houhouoch/UDP3900/Readme.md

屏幕暂定为3.71寸
使用的是SPI+RGB  +带触摸的IIC
屏幕驱动为ST7701S   触摸IC为CST3240
其中  屏幕驱动：使用的是三线SPI  9位bit  
此屏幕没有DC引脚，也就是没有专门的控制位来告诉MCU 这个数据是 命令还是数据
这里使用模拟SPI 的方式去初始化 因为是9位，如果使用spi外设来写 会很麻烦

第一步 初始spi 的gpio口
