houhouoch/UDP3900/APP/UDP3900_3.27_Btn/Readme.md

按键布局大致做了以下修改

后续的按键

后续定好的按键
8885ff6d24081e829a78c13145390b2e
