houhouoch/UDP3900/APP/Readme.md

## 📂 工程演进明细表 (Project Roadmap)

| 工程文件夹名称 | 开发日期 | 项目功能说明 |
| :--- | :---: | :--- |
| **UDP3900_3.25** |3.25 |SDRAM 读写测试 |
| **UDP3900_3.25_LTDC** | 3.25 | 显示屏移植与显示 |
| **UDP3900_3.25_DMA2D** | 3.25 |DMA2D使用。 |
| **UDP3900_3.26_FreeRTOS** | 3.26 |移植RTOS。 |
| **UDP3900_3.26_FreeRTOS_LVGLS** | 3.26 |移植LVGL。 |
| **UDP3900_3.27_FreeRTOS_LVGL_MUTEX_TEST** | 3.27 |修改了DMA2D,增加了互斥锁。 |
| **UDP3900_3.27_Btn** | 3.27 |把对应按键进行增加。 |
---
