houhouoch/UDP3900/其他/HD371001C40带触摸/56ff643bea4310fa22435de5ab40d1ec.jpg

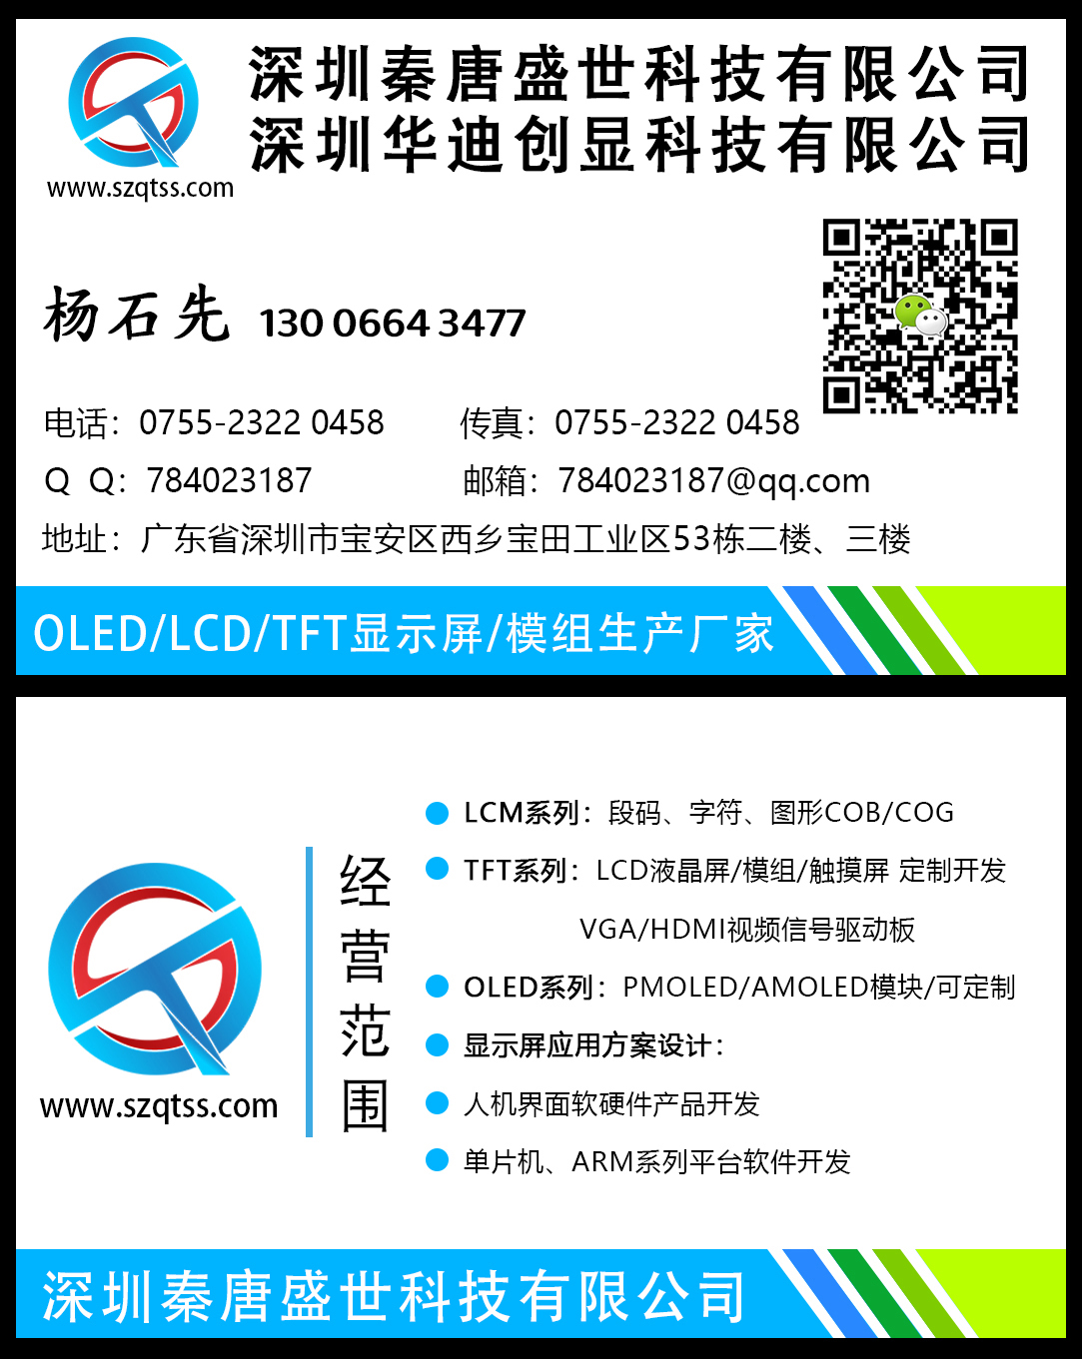
其他/HD371001C40带触摸/56ff643bea4310fa22435de5ab40d1ec.jpg
