houhouoch/UDP3900/其他/HD371001C40带触摸/屏参数.png

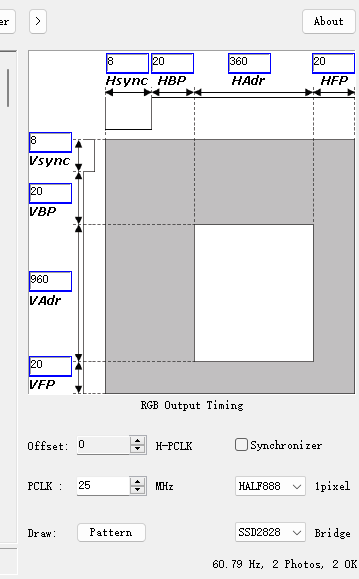
其他/HD371001C40带触摸/屏参数.png
