houhouoch/UDP3900/其他/1U 按键、显示、核心板/1U 按键.pdf

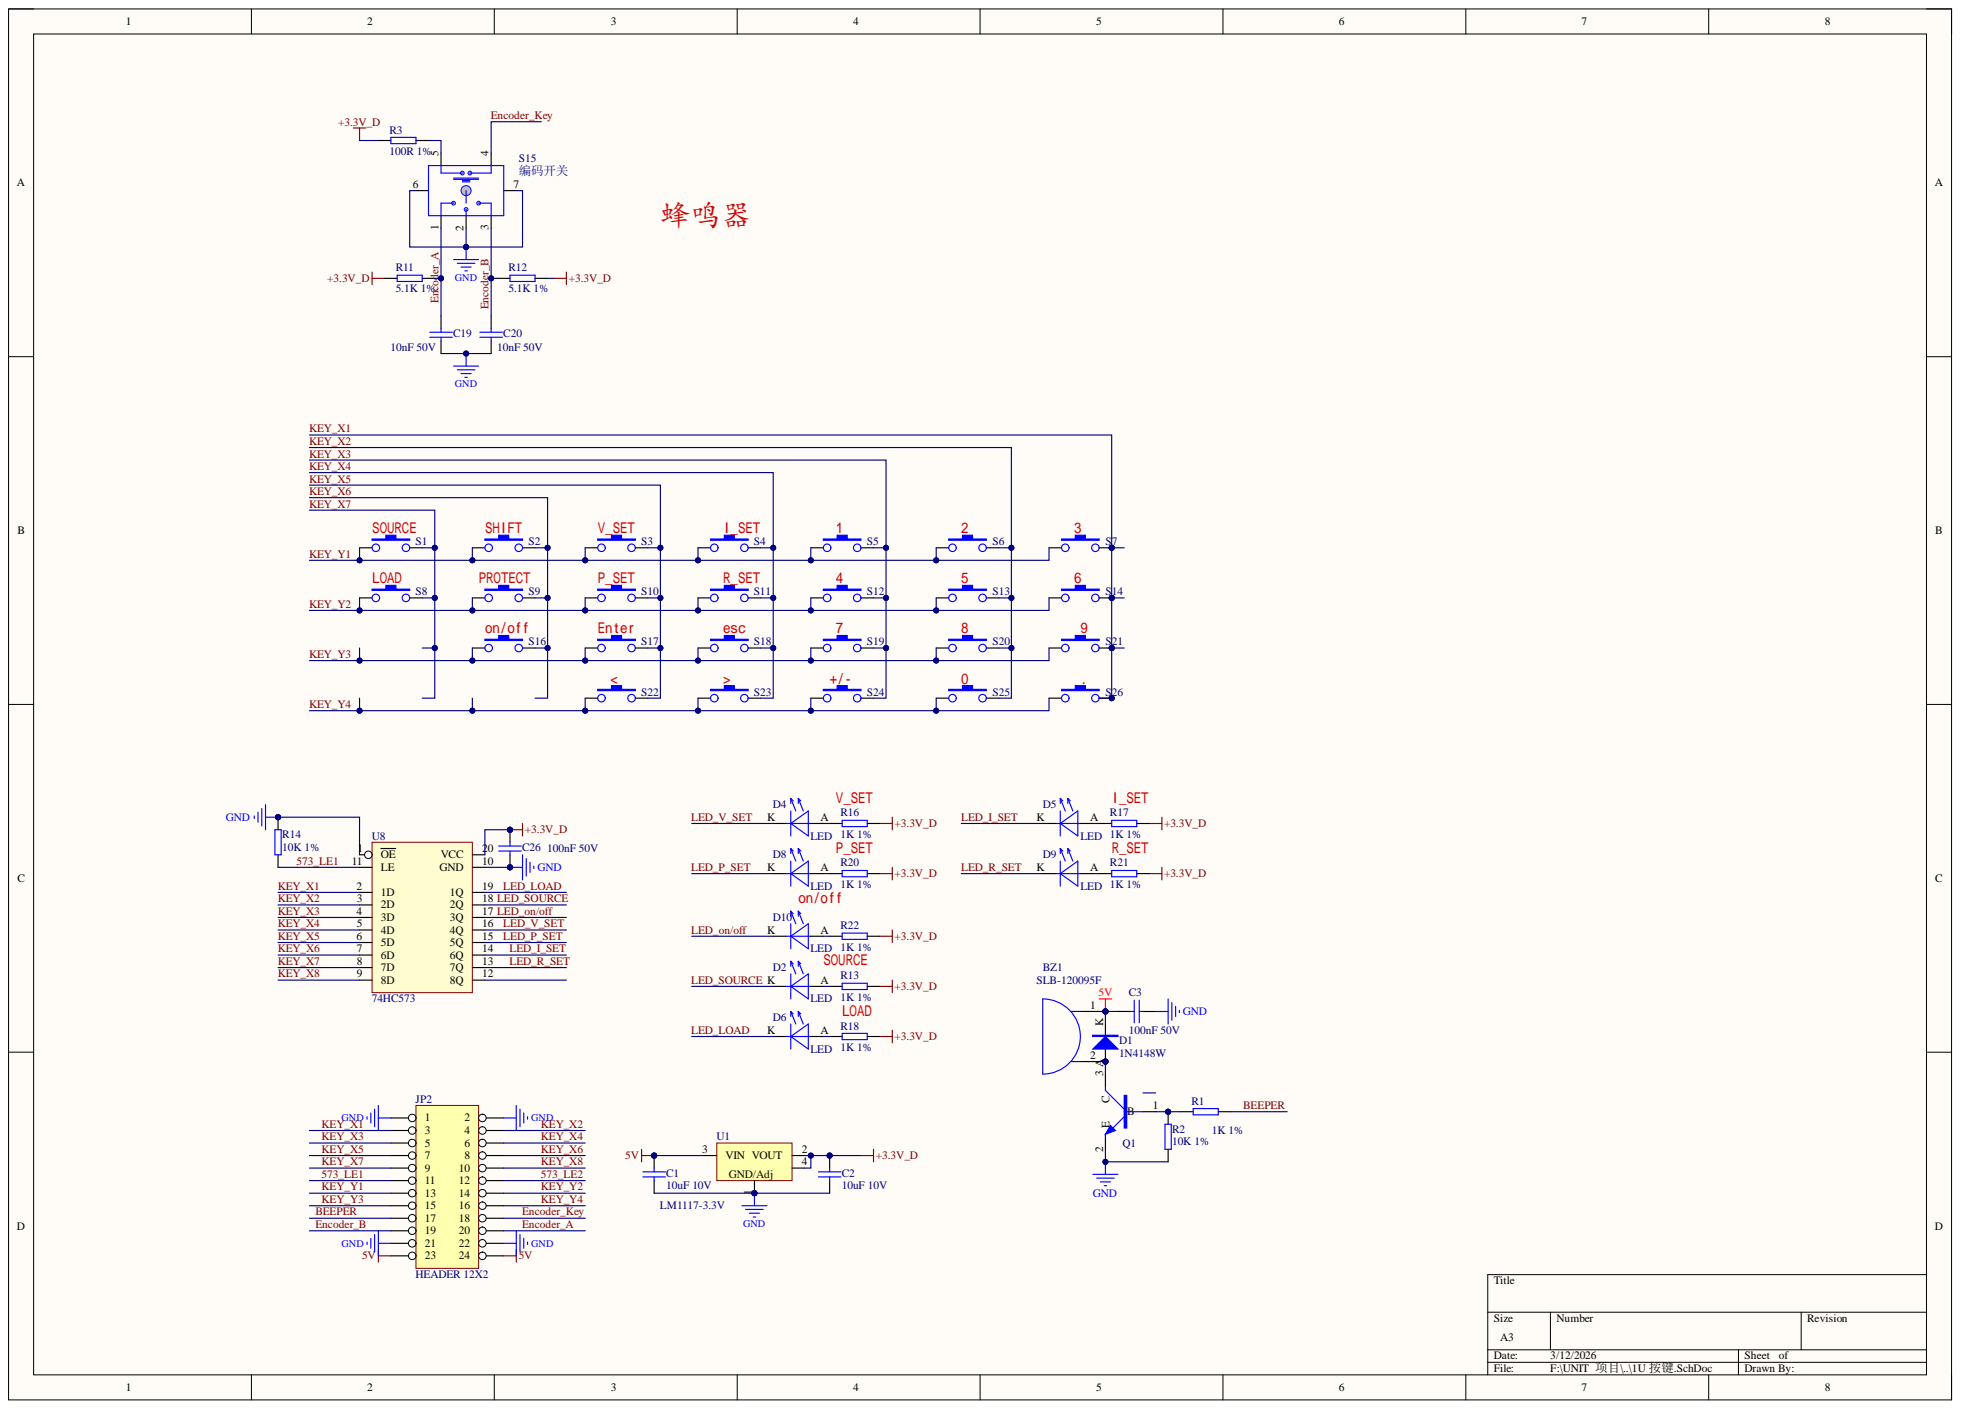
[picture p3: page 1]
