houhouoch/UDP3900/其他/1U 按键、显示、核心板/1U 显示.pdf

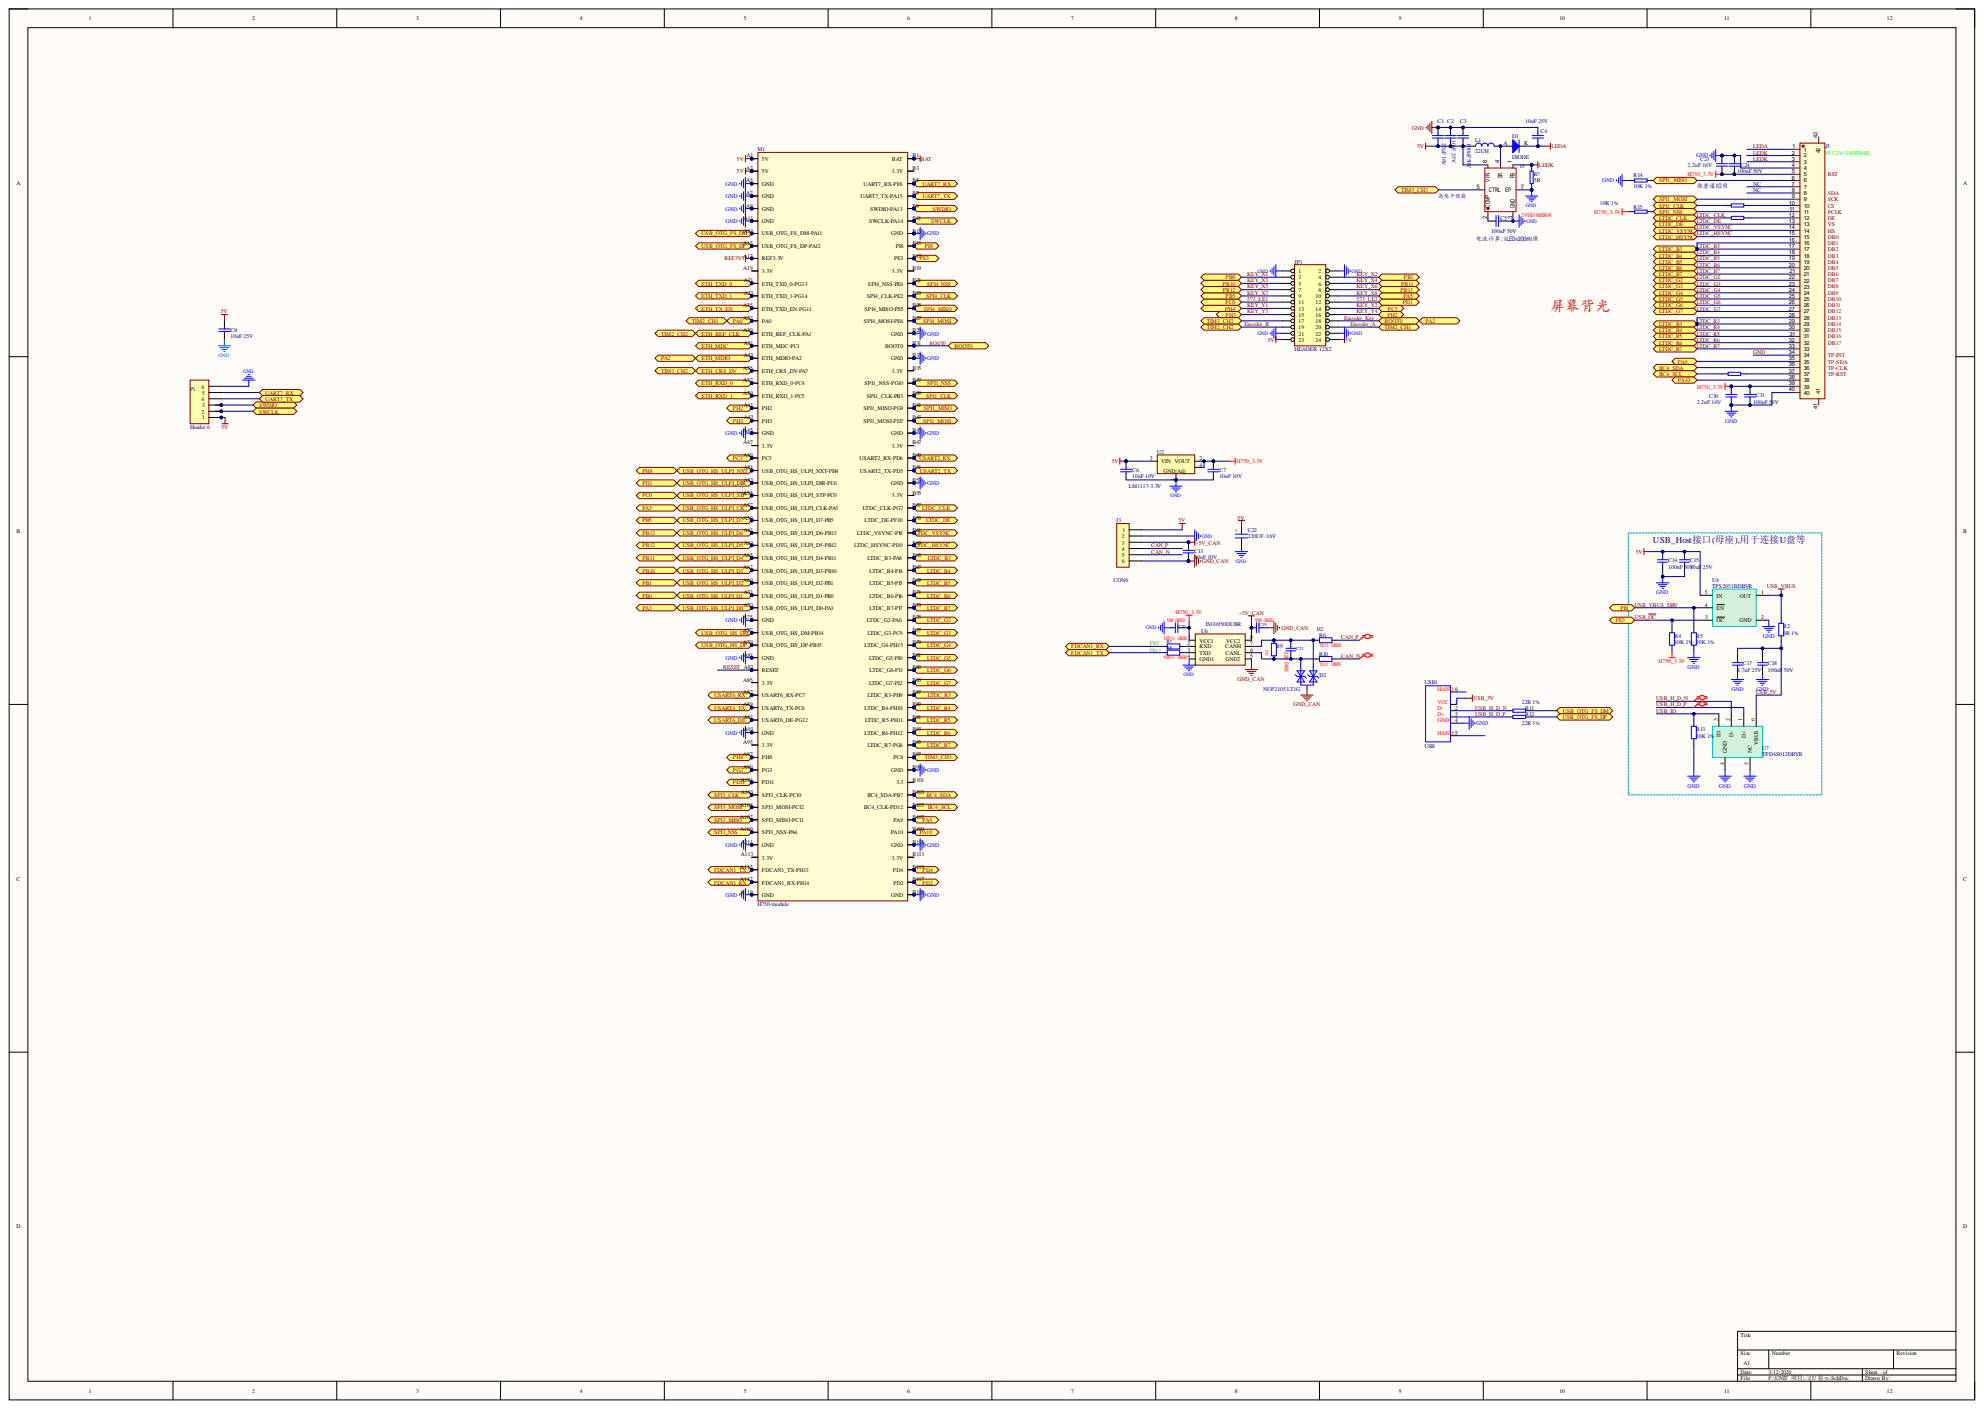
[picture p4: page 1]
