houhouoch/UDP3900/其他/1U 按键、显示、核心板/通用核心板.pdf

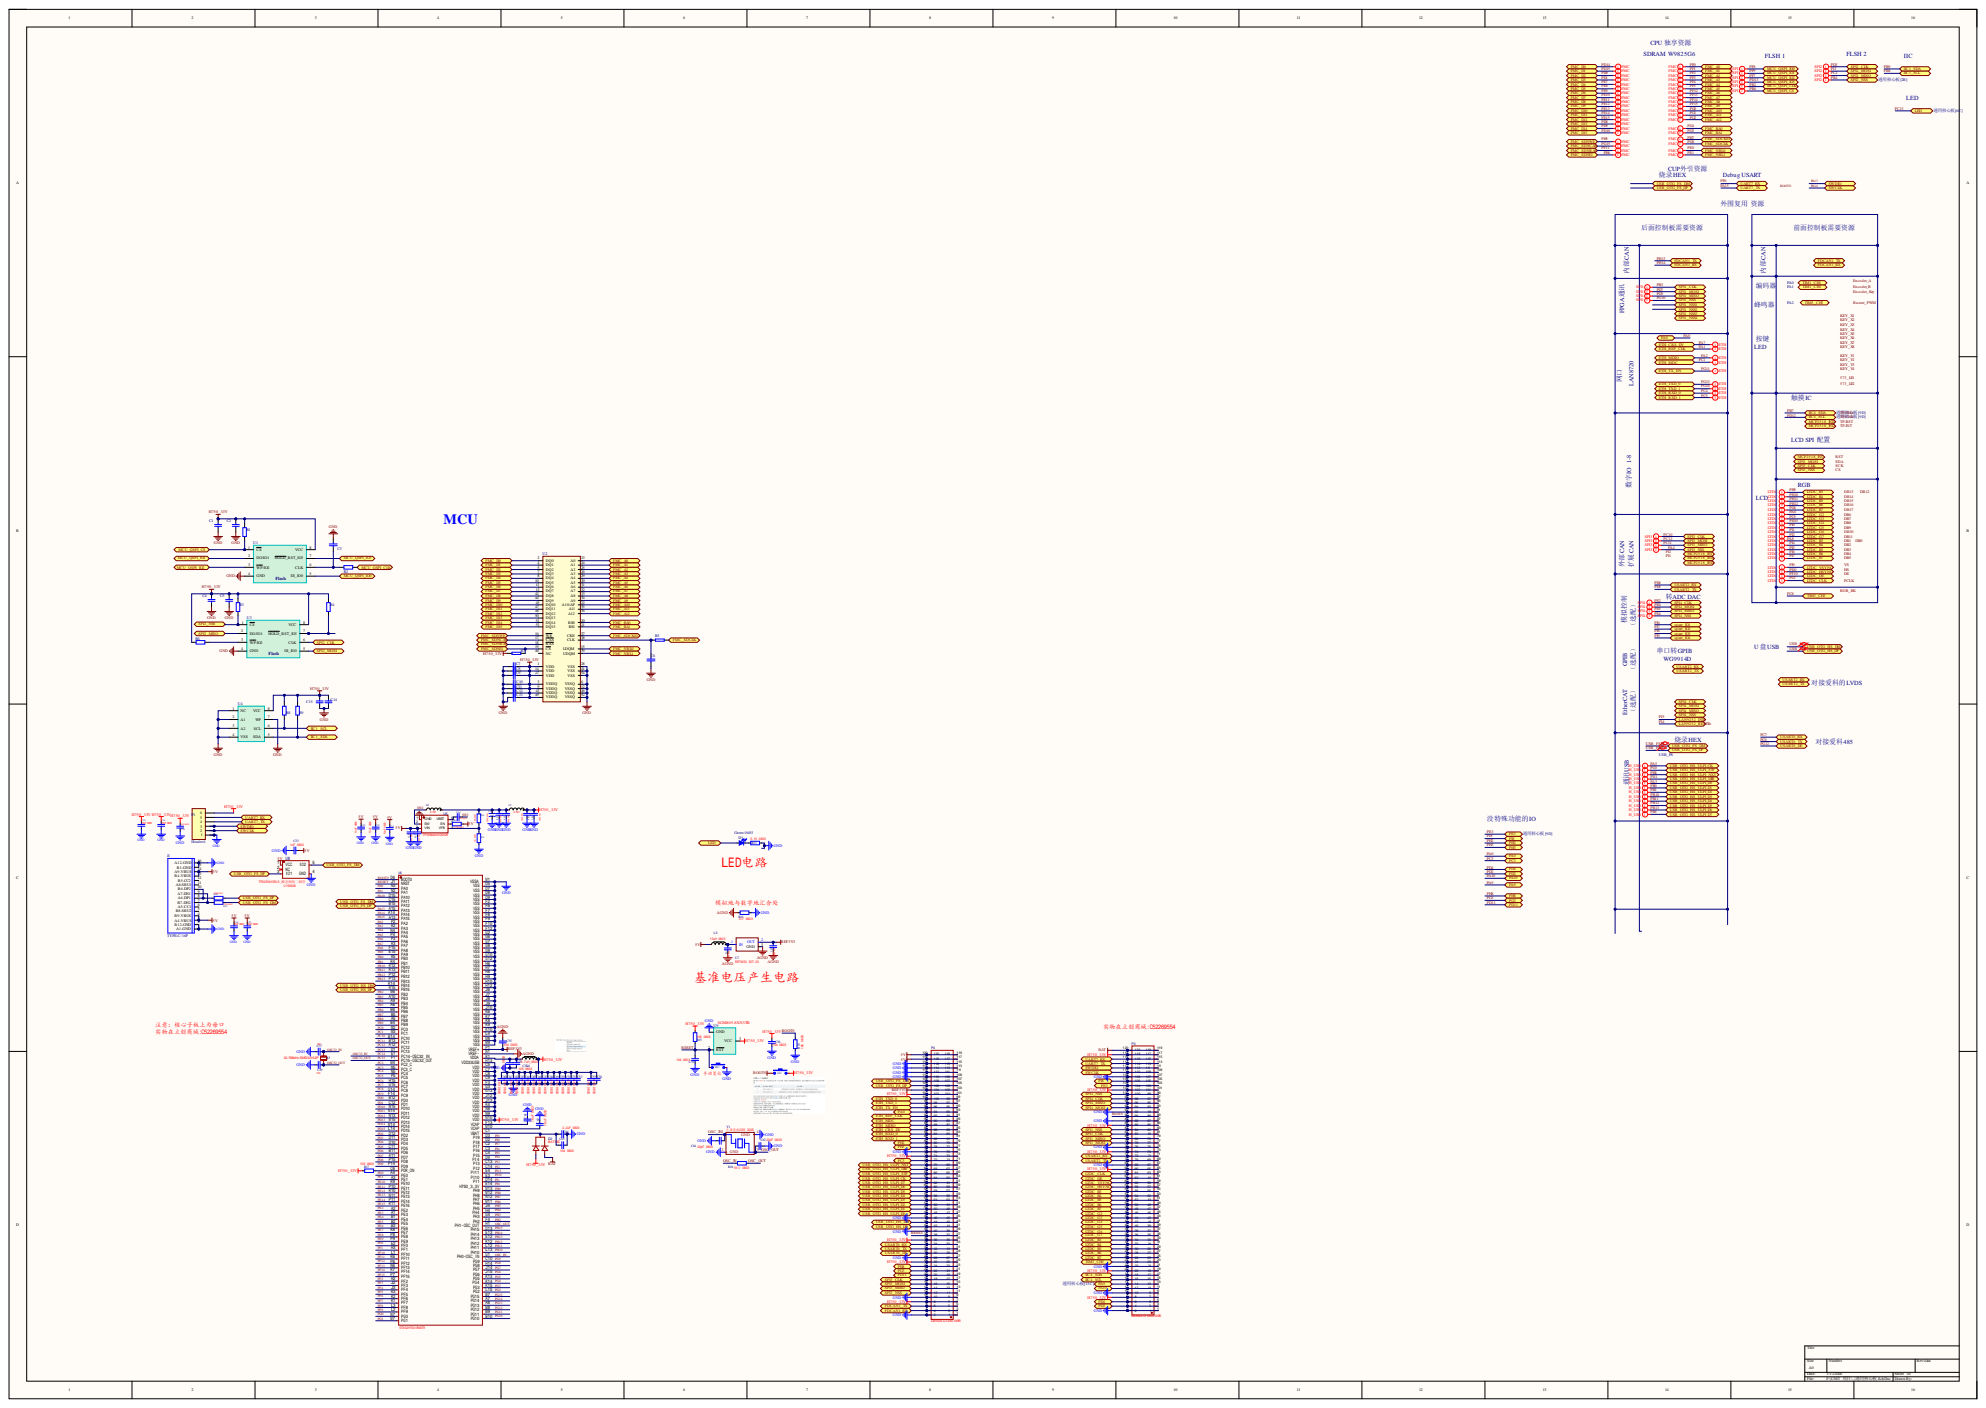
[picture p5: page 1]

数字IO 1-8 （选配） GPIB （选配） EtherCAT （选配）

C4 GND S P I 2 _NS S P I 2 _ R6 | C5 S M I S

P P D5 D6 USAR T 2 _RX 转ADC DAC USAR T 2 _ TX P E 2 S S P P I4 I4 i i P P E E 5 6 S S P P I4 I4 _ _ C MOS LK I S S P P I4 I4 i i P E4 S S P P I4 I4 _ _NS M I S S O P I 6P P I7 s s p p are are _ _ I I O1 O2 P P I I 8 9 s p are _ I O3 s p are _ I O4 串口转GP I B WG9 9 1 4D USAR USAR T T 2 2 _RX _ TX S P I4 _ C LK S P I4 _ MOS I S S P P I4 I4 _ _NS M I S S O P I4 I 5 LAN9 2 5 2 _ INTn LAN9 2 5 2 _ R E S ETn

H_US H_US H_US H_US H_US H_US H_US H_US H_US H_US H_US | 烧录HE US B _ F S_N USB_FS_P X US US B B _OTG_ _OTG_ F F S S _ _DP DM US B _ FS B i PA3 PA5 PB0 PB1 PB5 PB1 US B _OTG_HS _UL P I_CK B i P P C0 H4 US B _OTG_HS _UL P I_ S TP B B i i P I 1 1 US US B B _OTG_HS _OTG_HS _UL _UL P P I_NXT I_DIR USB_OTG_HS_ULPI_D0 B i B B i i US US B B _OTG_HS _OTG_HS _UL _UL P P I_D1 I_D2 B i H_USB i P B 1 1 0 US B _OTG_HS _UL P I_D3 USB_OTG_HS_ULPI_D4 B i P P B B 1 1 2 3 US B _OTG_HS _UL P I_D5 B B i i US US B B _OTG_HS _OTG_HS _UL _UL P P I_D6 I_D7
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
