houhouoch/UDP3900/(list of files, drawings)

Other design files:
其他/1U 按键/1U 按键.PrjPcb
其他/1U 按键/1U 按键.SchDoc
其他/1U 按键、显示、核心板/核心板/通用核心板.PrjPcb
其他/1U 按键、显示、核心板/核心板/通用核心板.SchDoc
其他/1U 显示/1U 显示.PcbDoc
其他/1U 显示/1U 显示.PrjPcb
其他/1U 显示/1U 显示.SchDoc
