houhouoch/UDP3900/QSPI_W25Q64_Flash的MDK下载算法制作/User/bsp/src/bsp_qspi_w25q256.c

/*
*********************************************************************************************************
*
*    模块名称 : W25Q256 QSPI驱动模块
*    文件名称 : bsp_qspi_w25q256.c
*    版    本 : V1.0
*    说    明 : 使用CPU的QSPI总线驱动串行FLASH，提供基本的读写函数，采用4线方式
*
*    修改记录 :
*        版本号  日期        作者     说明
*        V1.0    2019-02-12  armfly  正式发布
*        V1.1    2019-07-07  armfly  增加H7-TOOL引脚定义。
*
*    Copyright (C), 2019-2030, 安富莱电子 www.armfly.com
*
*********************************************************************************************************
*/
#include "stm32h7xx_hal.h"
#include "stm32h7xx_hal_pwr.h"
#include "stm32h7xx_hal_qspi.h"
#include "bsp_qspi_w25q256.h"

/**
 * @brief  3900项目 - QSPI Flash 接口引脚定义 (Bank 1)
 * @note   外设实例: QUADSPI
 * * | QSPI 信号 | 物理引脚 | 复用功能 (AF) | 核心板功能说明        |
 * |-----------|----------|---------------|-----------------------|
 * | CS        | PB6      | AF10          | QUADSPI_BK1_NCS       |
 * | CLK       | PB2      | AF9           | QUADSPI_CLK           |
 * | IO0       | PF8      | AF10          | QUADSPI_BK1_IO0       |
 * | IO1       | PF9      | AF10          | QUADSPI_BK1_IO1       |
 * | IO2       | PF7      | AF9           | QUADSPI_BK1_IO2       |
 * | IO3       | PD13     | AF9           | QUADSPI_BK1_IO3       |
 * 
 */


/* QSPI引脚和时钟相关配置宏定义 */
#if 1
#define QSPI_CLK_ENABLE()               __HAL_RCC_QSPI_CLK_ENABLE()
#define QSPI_CLK_DISABLE()              __HAL_RCC_QSPI_CLK_DISABLE()
#define QSPI_CS_GPIO_CLK_ENABLE()       __HAL_RCC_GPIOB_CLK_ENABLE()
#define QSPI_CLK_GPIO_CLK_ENABLE()      __HAL_RCC_GPIOB_CLK_ENABLE()
#define QSPI_BK1_D0_GPIO_CLK_ENABLE()   __HAL_RCC_GPIOF_CLK_ENABLE()
#define QSPI_BK1_D1_GPIO_CLK_ENABLE()   __HAL_RCC_GPIOF_CLK_ENABLE()
#define QSPI_BK1_D2_GPIO_CLK_ENABLE()   __HAL_RCC_GPIOF_CLK_ENABLE()
#define QSPI_BK1_D3_GPIO_CLK_ENABLE()   __HAL_RCC_GPIOD_CLK_ENABLE()

#define QSPI_MDMA_CLK_ENABLE()          __HAL_RCC_MDMA_CLK_ENABLE()
#define QSPI_FORCE_RESET()              __HAL_RCC_QSPI_FORCE_RESET()
#define QSPI_RELEASE_RESET()            __HAL_RCC_QSPI_RELEASE_RESET()

#define QSPI_CS_PIN                     GPIO_PIN_6
#define QSPI_CS_GPIO_PORT               GPIOB
#define QSPI_CS_GPIO_AF                 GPIO_AF10_QUADSPI

#define QSPI_CLK_PIN                    GPIO_PIN_2
#define QSPI_CLK_GPIO_PORT              GPIOB
#define QSPI_CLK_GPIO_AF                GPIO_AF9_QUADSPI

#define QSPI_BK1_D0_PIN                 GPIO_PIN_8
#define QSPI_BK1_D0_GPIO_PORT           GPIOF
#define QSPI_BK1_D0_GPIO_AF             GPIO_AF10_QUADSPI

#define QSPI_BK1_D1_PIN                 GPIO_PIN_9
#define QSPI_BK1_D1_GPIO_PORT           GPIOF
#define QSPI_BK1_D1_GPIO_AF             GPIO_AF10_QUADSPI

#define QSPI_BK1_D2_PIN                 GPIO_PIN_7
#define QSPI_BK1_D2_GPIO_PORT           GPIOF
#define QSPI_BK1_D2_GPIO_AF             GPIO_AF9_QUADSPI

#define QSPI_BK1_D3_PIN                 GPIO_PIN_13
#define QSPI_BK1_D3_GPIO_PORT           GPIOD
#define QSPI_BK1_D3_GPIO_AF             GPIO_AF9_QUADSPI
#endif


/* 供本文件调用的全局变量 */
static QSPI_HandleTypeDef QSPIHandle;

/* 供本文件调用的函数 */
static int QSPI_WriteEnable(QSPI_HandleTypeDef *hqspi);
static int QSPI_AutoPollingMemReady(QSPI_HandleTypeDef *hqspi);


/*
*********************************************************************************************************
*    函 数 名: bsp_InitQSPI_W25Q256
*    功能说明: QSPI Flash硬件初始化，配置基本参数
*    形    参: 无
*    返 回 值: 0 表示成功， 1 表示失败
*********************************************************************************************************
*/
int bsp_InitQSPI_W25Q256(void)
{
    uint32_t i;
    char *p;
    
    /* 将句柄手动清零，防止作为全局变量的时候没有清零 */
    p = (char *)&QSPIHandle;
    for (i = 0; i < sizeof(QSPI_HandleTypeDef); i++)
    {
        *p++ = 0;
    }
  
    /* 复位QSPI */
    QSPIHandle.Instance = QUADSPI;   
    
    if (HAL_QSPI_DeInit(&QSPIHandle) != HAL_OK)
    {
        return 1;
    }

    /* 设置时钟速度，QSPI clock = 200MHz / (ClockPrescaler+1) = 100MHz */
    QSPIHandle.Init.ClockPrescaler = 1;

    /* 设置FIFO阀值，范围1 - 32 */
    QSPIHandle.Init.FifoThreshold = 1;

    /* 
        QUADSPI在FLASH驱动信号后过半个CLK周期才对FLASH驱动的数据采样。
        在外部信号延迟时，这有利于推迟数据采样。
    */
    QSPIHandle.Init.SampleShifting = QSPI_SAMPLE_SHIFTING_HALFCYCLE;

    /* Flash大小是2^(FlashSize + 1) = 2^25 = 32MB */
    QSPIHandle.Init.FlashSize = QSPI_FLASH_SIZE; //QSPI_FLASH_SIZE - 1; 2020-03-04, 需要扩大一倍，否则内存映射方位最后1个地址时，会异常

    /* 命令之间的CS片选至少保持1个时钟周期的高电平 */
    QSPIHandle.Init.ChipSelectHighTime = QSPI_CS_HIGH_TIME_5_CYCLE;

    /*
       MODE0: 表示片选信号空闲期间，CLK时钟信号是低电平
       MODE3: 表示片选信号空闲期间，CLK时钟信号是高电平
    */
    QSPIHandle.Init.ClockMode = QSPI_CLOCK_MODE_0;

    /* QSPI有两个BANK，这里使用的BANK1 */
    QSPIHandle.Init.FlashID = QSPI_FLASH_ID_1;

    /* V7开发板仅使用了BANK1，这里是禁止双BANK */
    QSPIHandle.Init.DualFlash = QSPI_DUALFLASH_DISABLE;

    /* 初始化配置QSPI */
    if (HAL_QSPI_Init(&QSPIHandle) != HAL_OK)
    {
        return 1;
    }
    
    return 0;
}

/*
*********************************************************************************************************
*    函 数 名: HAL_QSPI_MspInit
*    功能说明: QSPI底层初始化，被HAL_QSPI_Init调用的底层函数
*    形    参: 无
*    返 回 值: 无
*********************************************************************************************************
*/
void HAL_QSPI_MspInit(QSPI_HandleTypeDef *hqspi)
{
    GPIO_InitTypeDef GPIO_InitStruct;

    /* 使能QPSI时钟  */
    QSPI_CLK_ENABLE();

    /* 复位时钟接口 */
    QSPI_FORCE_RESET();
    QSPI_RELEASE_RESET();    
    
    /* 使能GPIO时钟 */
    QSPI_CS_GPIO_CLK_ENABLE();
    QSPI_CLK_GPIO_CLK_ENABLE();
    QSPI_BK1_D0_GPIO_CLK_ENABLE();
    QSPI_BK1_D1_GPIO_CLK_ENABLE();
    QSPI_BK1_D2_GPIO_CLK_ENABLE();
    QSPI_BK1_D3_GPIO_CLK_ENABLE();

    /* QSPI CS GPIO 引脚配置 */
    GPIO_InitStruct.Pin = QSPI_CS_PIN;
    GPIO_InitStruct.Mode = GPIO_MODE_AF_PP;
    GPIO_InitStruct.Pull = GPIO_PULLUP;
    GPIO_InitStruct.Speed = GPIO_SPEED_FREQ_VERY_HIGH;
    GPIO_InitStruct.Alternate = QSPI_CS_GPIO_AF;
    HAL_GPIO_Init(QSPI_CS_GPIO_PORT, &GPIO_InitStruct);

    /* QSPI CLK GPIO 引脚配置 */
    GPIO_InitStruct.Pin = QSPI_CLK_PIN;
    GPIO_InitStruct.Pull = GPIO_NOPULL;
    GPIO_InitStruct.Alternate = QSPI_CLK_GPIO_AF;
    HAL_GPIO_Init(QSPI_CLK_GPIO_PORT, &GPIO_InitStruct);

    /* QSPI D0 GPIO pin 引脚配置 */
    GPIO_InitStruct.Pin = QSPI_BK1_D0_PIN;
    GPIO_InitStruct.Alternate = QSPI_BK1_D0_GPIO_AF;
    HAL_GPIO_Init(QSPI_BK1_D0_GPIO_PORT, &GPIO_InitStruct);

    /* QSPI D1 GPIO 引脚配置 */
    GPIO_InitStruct.Pin = QSPI_BK1_D1_PIN;
    GPIO_InitStruct.Alternate = QSPI_BK1_D1_GPIO_AF;
    HAL_GPIO_Init(QSPI_BK1_D1_GPIO_PORT, &GPIO_InitStruct);

    /* QSPI D2 GPIO 引脚配置 */
    GPIO_InitStruct.Pin = QSPI_BK1_D2_PIN;
    GPIO_InitStruct.Alternate = QSPI_BK1_D2_GPIO_AF;
    HAL_GPIO_Init(QSPI_BK1_D2_GPIO_PORT, &GPIO_InitStruct);

    /* QSPI D3 GPIO 引脚配置 */
    GPIO_InitStruct.Pin = QSPI_BK1_D3_PIN;
    GPIO_InitStruct.Alternate = QSPI_BK1_D3_GPIO_AF;
    HAL_GPIO_Init(QSPI_BK1_D3_GPIO_PORT, &GPIO_InitStruct);
}

/*
*********************************************************************************************************
*    函 数 名: HAL_QSPI_MspDeInit
*    功能说明: QSPI底层复位，被HAL_QSPI_Init调用的底层函数
*    形    参: hqspi QSPI_HandleTypeDef类型句柄
*    返 回 值: 无
*********************************************************************************************************
*/
void HAL_QSPI_MspDeInit(QSPI_HandleTypeDef *hqspi)
{
    /* 复位QSPI引脚 */
    HAL_GPIO_DeInit(QSPI_CS_GPIO_PORT, QSPI_CS_PIN);
    HAL_GPIO_DeInit(QSPI_CLK_GPIO_PORT, QSPI_CLK_PIN);
    HAL_GPIO_DeInit(QSPI_BK1_D0_GPIO_PORT, QSPI_BK1_D0_PIN);
    HAL_GPIO_DeInit(QSPI_BK1_D1_GPIO_PORT, QSPI_BK1_D1_PIN);
    HAL_GPIO_DeInit(QSPI_BK1_D2_GPIO_PORT, QSPI_BK1_D2_PIN);
    HAL_GPIO_DeInit(QSPI_BK1_D3_GPIO_PORT, QSPI_BK1_D3_PIN);

    /* 复位QSPI */
    QSPI_FORCE_RESET();
    QSPI_RELEASE_RESET();

    /* 关闭QSPI时钟 */
    QSPI_CLK_DISABLE();
}

/*
*********************************************************************************************************
*    函 数 名: sf_EraseSector
*    功能说明: 擦除指定的扇区，扇区大小64KB
*    形    参: _uiSectorAddr : 扇区地址，以64KB为单位的地址
*    返 回 值: 无
*********************************************************************************************************
*/
int QSPI_EraseSector(uint32_t address)
{
    QSPI_CommandTypeDef sCommand = {0};

    /* 写使能 */
    QSPI_WriteEnable(&QSPIHandle);

    /* 基本配置 */
    sCommand.InstructionMode = QSPI_INSTRUCTION_1_LINE;             /* 1线方式发送指令 */
    sCommand.AddressSize = QSPI_ADDRESS_24_BITS;                    /* 32位地址 */
    sCommand.AlternateByteMode = QSPI_ALTERNATE_BYTES_NONE;         /* 无交替字节 */
    sCommand.DdrMode = QSPI_DDR_MODE_DISABLE;                       /* W25Q256JV不支持DDR */
    sCommand.DdrHoldHalfCycle = QSPI_DDR_HHC_ANALOG_DELAY;          /* DDR模式，数据输出延迟 */
    sCommand.SIOOMode = QSPI_SIOO_INST_EVERY_CMD;                   /* 每次传输都发指令 */

    /* 擦除配置 */
    sCommand.Instruction = BLOCK_ERASE_64K_4_BYTE_ADDR_CMD;         /* 32bit地址方式的扇区擦除命令，扇区大小64KB*/
    
    sCommand.AddressMode = QSPI_ADDRESS_1_LINE;                     /* 地址发送是1线方式 */
    sCommand.Address = address;                                     /* 扇区首地址，保证是4KB整数倍 */
    sCommand.DataMode = QSPI_DATA_NONE;                             /* 无需发送数据 */
    sCommand.DummyCycles = 0;                                       /* 无需空周期 */

    if (HAL_QSPI_Command(&QSPIHandle, &sCommand, 0) != HAL_OK)
    {
       return 1;
    }

    /* 等待编程结束 */
    if (QSPI_AutoPollingMemReady(&QSPIHandle) == 1)
    {
        return 1;
    }

    return 0;
}

/*
*********************************************************************************************************
*    函 数 名: QSPI_EraseChip
*    功能说明: 擦除整片
*    形    参: 无
*    返 回 值: 无
*********************************************************************************************************
*/
int QSPI_EraseChip(void)
{
    QSPI_CommandTypeDef sCommand = {0};

    /* 写使能 */
    QSPI_WriteEnable(&QSPIHandle);

    /* 基本配置 */
    sCommand.InstructionMode = QSPI_INSTRUCTION_1_LINE;             /* 1线方式发送指令 */
    sCommand.AddressSize = QSPI_ADDRESS_24_BITS;                    /* 32位地址 */
    sCommand.AlternateByteMode = QSPI_ALTERNATE_BYTES_NONE;         /* 无交替字节 */
    sCommand.DdrMode = QSPI_DDR_MODE_DISABLE;                       /* W25Q256JV不支持DDR */
    sCommand.DdrHoldHalfCycle = QSPI_DDR_HHC_ANALOG_DELAY;          /* DDR模式，数据输出延迟 */
    sCommand.SIOOMode = QSPI_SIOO_INST_EVERY_CMD;                   /* 每次传输都发指令 */

    /* 擦除配置 */
    sCommand.Instruction = BULK_ERASE_CMD;                          /* 32bit地址方式的扇区擦除命令，扇区大小64KB*/
    sCommand.AddressMode = QSPI_ADDRESS_1_LINE;                     /* 地址发送是1线方式 */
    sCommand.Address = 0;                                           /* */
    sCommand.DataMode = QSPI_DATA_NONE;                             /* 无需发送数据 */
    sCommand.DummyCycles = 0;                                       /* 无需空周期 */

    if (HAL_QSPI_Command(&QSPIHandle, &sCommand, 0) != HAL_OK)
    {
       return 1;
    }

    /* 等待编程结束 */
    if (QSPI_AutoPollingMemReady(&QSPIHandle) == 1)
    {
        return 1;
    }

    return 0;
}

/*
*********************************************************************************************************
*    函 数 名: QSPI_WriteBuffer
*    功能说明: 页编程，页大小256字节，任意页都可以写入
*    形    参: _pBuf : 数据源缓冲区；
*              _uiWrAddr ：目标区域首地址，即页首地址，比如0， 256, 512等。
*              _usSize ：数据个数，不能超过页面大小，范围1 - 256。
*    返 回 值: 0:成功， 1：失败
*********************************************************************************************************
*/
int QSPI_WriteBuffer(uint8_t *_pBuf, uint32_t _uiWriteAddr, uint16_t _usWriteSize)
{
    QSPI_CommandTypeDef sCommand = {0};

    /* 写使能 */
    QSPI_WriteEnable(&QSPIHandle);

    /* 基本配置 */
    sCommand.InstructionMode = QSPI_INSTRUCTION_1_LINE;         /* 1线方式发送指令 */
    sCommand.AddressSize = QSPI_ADDRESS_24_BITS;                /* 32位地址 */
    sCommand.AlternateByteMode = QSPI_ALTERNATE_BYTES_NONE;     /* 无交替字节 */
    sCommand.DdrMode = QSPI_DDR_MODE_DISABLE;                   /* W25Q256JV不支持DDR */
    sCommand.DdrHoldHalfCycle = QSPI_DDR_HHC_ANALOG_DELAY;      /* DDR模式，数据输出延迟 */
    sCommand.SIOOMode = QSPI_SIOO_INST_ONLY_FIRST_CMD;          /* 仅发送一次命令 */

    /* 写序列配置 */
    sCommand.Instruction = QUAD_IN_FAST_PROG_4_BYTE_ADDR_CMD;   /* 32bit地址的4线快速写入命令 */
    sCommand.DummyCycles = 0;                                   /* 不需要空周期 */
    sCommand.AddressMode = QSPI_ADDRESS_1_LINE;                 /* 4线地址方式 */
    sCommand.DataMode = QSPI_DATA_4_LINES;                      /* 4线数据方式 */
    sCommand.NbData = _usWriteSize;                             /* 写数据大小 */
    sCommand.Address = _uiWriteAddr;                            /* 写入地址 */

    if (HAL_QSPI_Command(&QSPIHandle, &sCommand, HAL_QPSI_TIMEOUT_DEFAULT_VALUE) != HAL_OK)
    {
        return 1;
    }

    /* 启动传输 */
    if (HAL_QSPI_Transmit(&QSPIHandle, _pBuf, 0) != HAL_OK)
    {
         return 1;
    }


    /* 等待Flash页编程完毕 */
    if (QSPI_AutoPollingMemReady(&QSPIHandle) == 1)
    {
        return 0;
    }

    return 0;
}

/*
*********************************************************************************************************
*    函 数 名: QSPI_ReadBuffer
*    功能说明: 连续读取若干字节，字节个数不能超出芯片容量。
*    形    参: _pBuf : 数据源缓冲区。
*              _uiReadAddr ：起始地址。
*              _usSize ：数据个数, 可以大于PAGE_SIZE, 但是不能超出芯片总容量。
*    返 回 值: 无
*********************************************************************************************************
*/
int QSPI_ReadBuffer(uint8_t *_pBuf, uint32_t _uiReadAddr, uint32_t _uiSize)
{
    QSPI_CommandTypeDef sCommand = {0};

    /* 基本配置 */
    sCommand.InstructionMode = QSPI_INSTRUCTION_1_LINE;             /* 1线方式发送指令 */
    sCommand.AddressSize = QSPI_ADDRESS_24_BITS;                    /* 32位地址 */
    sCommand.AlternateByteMode = QSPI_ALTERNATE_BYTES_NONE;         /* 无交替字节 */
    sCommand.DdrMode = QSPI_DDR_MODE_DISABLE;                       /* W25Q256JV不支持DDR */
    sCommand.DdrHoldHalfCycle = QSPI_DDR_HHC_ANALOG_DELAY;          /* DDR模式，数据输出延迟 */
    sCommand.SIOOMode = QSPI_SIOO_INST_EVERY_CMD;                   /* 每次传输要发指令 */

    /* 读取数据 */
    sCommand.Instruction = QUAD_INOUT_FAST_READ_4_BYTE_ADDR_CMD;    /* 32bit地址的4线快速读取命令 */
    sCommand.DummyCycles = 6;                                       /* 空周期 */
    sCommand.AddressMode = QSPI_ADDRESS_4_LINES;                    /* 4线地址 */
    sCommand.DataMode = QSPI_DATA_4_LINES;                          /* 4线数据 */
    sCommand.NbData = _uiSize;                                      /* 读取的数据大小 */
    sCommand.Address = _uiReadAddr;                                 /* 读取数据的起始地址 */

    if (HAL_QSPI_Command(&QSPIHandle, &sCommand, HAL_QPSI_TIMEOUT_DEFAULT_VALUE) != HAL_OK)
    {
        return 1;
    }

    /* 接收数据 */
    if (HAL_QSPI_Receive(&QSPIHandle, _pBuf, 0) != HAL_OK)
    {
        return 1;
    }
    
    return 0;
}

/*
*********************************************************************************************************
*    函 数 名: QSPI_WriteEnable
*    功能说明: 写使能
*    形    参: hqspi  QSPI_HandleTypeDef句柄。
*    返 回 值: 无
*********************************************************************************************************
*/
static int QSPI_WriteEnable(QSPI_HandleTypeDef *hqspi)
{
    QSPI_CommandTypeDef sCommand = {0};

    /* 基本配置 */
    sCommand.InstructionMode = QSPI_INSTRUCTION_1_LINE;             /* 1线方式发送指令 */
    sCommand.AddressSize = QSPI_ADDRESS_24_BITS;                    /* 32位地址 */
    sCommand.AlternateByteMode = QSPI_ALTERNATE_BYTES_NONE;         /* 无交替字节 */
    sCommand.DdrMode = QSPI_DDR_MODE_DISABLE;                       /* W25Q256JV不支持DDR */
    sCommand.DdrHoldHalfCycle = QSPI_DDR_HHC_ANALOG_DELAY;          /* DDR模式，数据输出延迟 */
    sCommand.SIOOMode = QSPI_SIOO_INST_EVERY_CMD;                   /* 每次传输都发指令 */

    /* 写使能 */
    sCommand.Instruction = WRITE_ENABLE_CMD;                        /* 写使能指令 */
    sCommand.AddressMode = QSPI_ADDRESS_NONE;                       /* 无需地址 */
    sCommand.DataMode = QSPI_DATA_NONE;                             /* 无需数据 */
    sCommand.DummyCycles = 0;                                       /* 空周期  */

    if (HAL_QSPI_Command(&QSPIHandle, &sCommand, HAL_QPSI_TIMEOUT_DEFAULT_VALUE) != HAL_OK)
    {
        return 1;
    }
    
    return 0;        
}
void QSPI_Flash_WriteEnable(void)
{
    QSPI_WriteEnable(&QSPIHandle);
}
/*
*********************************************************************************************************
*    函 数 名: QSPI_AutoPollingMemReady
*    功能说明: 等待QSPI Flash就绪，主要用于Flash擦除和页编程时使用
*    形    参: hqspi  QSPI_HandleTypeDef句柄
*    返 回 值: 无
*********************************************************************************************************
*/
static int QSPI_AutoPollingMemReady(QSPI_HandleTypeDef *hqspi)
{
    QSPI_CommandTypeDef sCommand = {0};
    QSPI_AutoPollingTypeDef sConfig = {0};

    /* 基本配置 */
    sCommand.InstructionMode = QSPI_INSTRUCTION_1_LINE;             /* 1线方式发送指令 */
    sCommand.AddressSize = QSPI_ADDRESS_24_BITS;                    /* 32位地址 */
    sCommand.AlternateByteMode = QSPI_ALTERNATE_BYTES_NONE;         /* 无交替字节 */
    sCommand.DdrMode = QSPI_DDR_MODE_DISABLE;                       /* W25Q256JV不支持DDR */
    sCommand.DdrHoldHalfCycle = QSPI_DDR_HHC_ANALOG_DELAY;          /* DDR模式，数据输出延迟 */
    sCommand.SIOOMode = QSPI_SIOO_INST_EVERY_CMD;                   /* 每次传输都发指令 */

    /* 读取状态*/
    sCommand.Instruction = READ_STATUS_REG_CMD;                     /* 读取状态命令 */
    sCommand.AddressMode = QSPI_ADDRESS_NONE;                       /* 无需地址 */
    sCommand.DataMode = QSPI_DATA_1_LINE;                           /* 1线数据 */
    sCommand.DummyCycles = 0;                                       /* 无需空周期 */

    /* 屏蔽位设置的bit0，匹配位等待bit0为0，即不断查询状态寄存器bit0，等待其为0 */
    sConfig.Mask = 0x01;
    sConfig.Match = 0x00;
    sConfig.MatchMode = QSPI_MATCH_MODE_AND;
    sConfig.StatusBytesSize = 1;
    sConfig.Interval = 0x10;
    sConfig.AutomaticStop = QSPI_AUTOMATIC_STOP_ENABLE;

    if (HAL_QSPI_AutoPolling(&QSPIHandle, &sCommand, &sConfig, 0) != HAL_OK)
    {
        return 1;
    }
    
    return 0;
}

/*
*********************************************************************************************************
*    函 数 名: QSPI_ReadID
*    功能说明: 读取器件ID
*    形    参: 无
*    返 回 值: 32bit的器件ID (最高8bit填0，有效ID位数为24bit）
*********************************************************************************************************
*/
uint32_t QSPI_ReadID(void)
{
    uint32_t uiID = 0x0;
    QSPI_CommandTypeDef s_command = {0};
    uint8_t buf[3];

    /* 基本配置 */
    s_command.InstructionMode = QSPI_INSTRUCTION_1_LINE;            /* 1线方式发送指令 */
    s_command.AddressSize = QSPI_ADDRESS_24_BITS;                   /* 32位地址 */
    s_command.AlternateByteMode = QSPI_ALTERNATE_BYTES_NONE;        /* 无交替字节 */
    s_command.DdrMode = QSPI_DDR_MODE_DISABLE;                      /* W25Q256JV不支持DDR */
    s_command.DdrHoldHalfCycle = QSPI_DDR_HHC_ANALOG_DELAY;         /* DDR模式，数据输出延迟 */
    s_command.SIOOMode = QSPI_SIOO_INST_EVERY_CMD;                  /* 每次传输都发指令 */

    /* 读取JEDEC ID */
    s_command.Instruction = READ_ID_CMD2;                           /* 读取ID命令 */
    s_command.AddressMode = QSPI_ADDRESS_NONE;                      /* 1线地址 */
    s_command.DataMode = QSPI_DATA_1_LINE;                          /* 1线地址 */
    s_command.DummyCycles = 0;                                      /* 无空周期 */
    s_command.NbData = 3;                                           /* 读取三个数据 */

    if (HAL_QSPI_Command(&QSPIHandle, &s_command, HAL_QPSI_TIMEOUT_DEFAULT_VALUE) != HAL_OK)
    {
    }

    if (HAL_QSPI_Receive(&QSPIHandle, buf, HAL_QPSI_TIMEOUT_DEFAULT_VALUE) != HAL_OK)
    {
    }

    uiID = (buf[0] << 16) | (buf[1] << 8) | buf[2];

    return uiID;
}

/*
*********************************************************************************************************
*    函 数 名: QSPI_MemoryMapped
*    功能说明: QSPI内存映射，地址 0x90000000
*    形    参: 无
*    返 回 值: 无
*********************************************************************************************************
*/
int QSPI_MemoryMapped(void)
{
    QSPI_CommandTypeDef s_command = {0};
    QSPI_MemoryMappedTypeDef s_mem_mapped_cfg = {0};
    

    /* 基本配置 */
    s_command.InstructionMode = QSPI_INSTRUCTION_1_LINE;      /* 1线方式发送指令 */ 
    s_command.AddressSize = QSPI_ADDRESS_24_BITS;             /* 32位地址 */
    s_command.AlternateByteMode = QSPI_ALTERNATE_BYTES_NONE;  /* 无交替字节 */
    s_command.DdrMode = QSPI_DDR_MODE_DISABLE;                /* W25Q256JV不支持DDR */
    s_command.DdrHoldHalfCycle = QSPI_DDR_HHC_ANALOG_DELAY;   /* DDR模式，数据输出延迟 */
    s_command.SIOOMode = QSPI_SIOO_INST_EVERY_CMD;            /* 每次传输都发指令 */
    
    /* 全部采用4线 */
    s_command.Instruction = QUAD_INOUT_FAST_READ_4_BYTE_ADDR_CMD; /* 快速读取命令 */
    s_command.AddressMode = QSPI_ADDRESS_4_LINES;                 /* 4个地址线 */
    s_command.DataMode = QSPI_DATA_4_LINES;                       /* 4个数据线 */
    s_command.DummyCycles = 6;                                    /* 空周期 */

    /* 关闭溢出计数 */
    s_mem_mapped_cfg.TimeOutActivation = QSPI_TIMEOUT_COUNTER_DISABLE;
    s_mem_mapped_cfg.TimeOutPeriod = 0;

    
    if (HAL_QSPI_MemoryMapped(&QSPIHandle, &s_command, &s_mem_mapped_cfg) != HAL_OK)
    {
        return 1;
    }

    return 0;
}

/*
*********************************************************************************************************
*    函 数 名: QSPI_QuitMemoryMapped
*    功能说明: QSPI内存映射，地址 0x90000000
*    形    参: 无
*    返 回 值: 无
*********************************************************************************************************
*/
int QSPI_QuitMemoryMapped(void)
{
    HAL_QSPI_Abort(&QSPIHandle);
 
    return 0;
}
          
/***************************** 安富莱电子 www.armfly.com (END OF FILE) *********************************/
