houhouoch/UDP3900/APP/UDP3900_4.2_read_back/Core/Src/fmc.c

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

/* Includes ------------------------------------------------------------------*/
#include "fmc.h"

/* USER CODE BEGIN 0 */

#define SDRAM_MODEREG_BURST_LENGTH_1                0x00000000
#define SDRAM_MODEREG_BURST_LENGTH_2                0x00000001
#define SDRAM_MODEREG_BURST_LENGTH_4                0x00000002
#define SDRAM_MODEREG_BURST_LENGTH_8                0x00000004
#define SDRAM_MODEREG_BURST_TYPE_SEQUENTIAL         0x00000000
#define SDRAM_MODEREG_BURST_TYPE_INTERLEAVED        0x00000008
#define SDRAM_MODEREG_CAS_LATENCY_2                 0x00000020
#define SDRAM_MODEREG_CAS_LATENCY_3                 0x00000030
#define SDRAM_MODEREG_OPERATING_MODE_STANDARD       0x00000000
#define SDRAM_MODEREG_WRITEBURST_MODE_PROGRAMMED    0x00000000
#define SDRAM_MODEREG_WRITEBURST_MODE_SINGLE        0x00000200

SDRAM_HandleTypeDef g_sdram_handle = {0};   

static void sdram_initialization_sequence(void)
{
    FMC_SDRAM_CommandTypeDef fmc_sdram_command_struct = {0};
    

    fmc_sdram_command_struct.CommandMode = FMC_SDRAM_CMD_CLK_ENABLE;
    fmc_sdram_command_struct.CommandTarget = FMC_SDRAM_CMD_TARGET_BANK2;
    fmc_sdram_command_struct.AutoRefreshNumber = 1;
    fmc_sdram_command_struct.ModeRegisterDefinition = 0;
    HAL_SDRAM_SendCommand(&hsdram1, &fmc_sdram_command_struct, 0xFFFF);
    

    HAL_Delay(1);
    

    fmc_sdram_command_struct.CommandMode = FMC_SDRAM_CMD_PALL;
    fmc_sdram_command_struct.CommandTarget = FMC_SDRAM_CMD_TARGET_BANK2;
    fmc_sdram_command_struct.AutoRefreshNumber = 1;
    fmc_sdram_command_struct.ModeRegisterDefinition = 0;
    HAL_SDRAM_SendCommand(&hsdram1, &fmc_sdram_command_struct, 0xFFFF);
    

    fmc_sdram_command_struct.CommandMode = FMC_SDRAM_CMD_AUTOREFRESH_MODE;
    fmc_sdram_command_struct.CommandTarget = FMC_SDRAM_CMD_TARGET_BANK2;
    fmc_sdram_command_struct.AutoRefreshNumber = 8;
    fmc_sdram_command_struct.ModeRegisterDefinition = 0;
    HAL_SDRAM_SendCommand(&hsdram1, &fmc_sdram_command_struct, 0xFFFF);
    

    fmc_sdram_command_struct.CommandMode = FMC_SDRAM_CMD_LOAD_MODE;
    fmc_sdram_command_struct.CommandTarget = FMC_SDRAM_CMD_TARGET_BANK2;
    fmc_sdram_command_struct.AutoRefreshNumber = 1;
    fmc_sdram_command_struct.ModeRegisterDefinition = SDRAM_MODEREG_BURST_LENGTH_1 |
                                                      SDRAM_MODEREG_BURST_TYPE_SEQUENTIAL |
                                                      SDRAM_MODEREG_CAS_LATENCY_2 |
                                                      SDRAM_MODEREG_OPERATING_MODE_STANDARD |
                                                      SDRAM_MODEREG_WRITEBURST_MODE_SINGLE;
    HAL_SDRAM_SendCommand(&hsdram1, &fmc_sdram_command_struct, 0xFFFF);
    
   
    HAL_SDRAM_ProgramRefreshRate(&hsdram1, 918);
}
/* USER CODE END 0 */

SDRAM_HandleTypeDef hsdram1;

/* FMC initialization function */
void MX_FMC_Init(void)
{
  FMC_SDRAM_TimingTypeDef SdramTiming = {0};

  /** Perform the SDRAM1 memory initialization sequence
  */
  hsdram1.Instance = FMC_SDRAM_DEVICE;
  /* hsdram1.Init */
  hsdram1.Init.SDBank = FMC_SDRAM_BANK2;
  hsdram1.Init.ColumnBitsNumber = FMC_SDRAM_COLUMN_BITS_NUM_9;
  hsdram1.Init.RowBitsNumber = FMC_SDRAM_ROW_BITS_NUM_13;
  hsdram1.Init.MemoryDataWidth = FMC_SDRAM_MEM_BUS_WIDTH_16;
  hsdram1.Init.InternalBankNumber = FMC_SDRAM_INTERN_BANKS_NUM_4;
  hsdram1.Init.CASLatency = FMC_SDRAM_CAS_LATENCY_2;
  hsdram1.Init.WriteProtection = FMC_SDRAM_WRITE_PROTECTION_DISABLE;
  hsdram1.Init.SDClockPeriod = FMC_SDRAM_CLOCK_PERIOD_2;
  hsdram1.Init.ReadBurst = FMC_SDRAM_RBURST_ENABLE;
  hsdram1.Init.ReadPipeDelay = FMC_SDRAM_RPIPE_DELAY_0;
  /* SdramTiming */
  SdramTiming.LoadToActiveDelay = 2;
  SdramTiming.ExitSelfRefreshDelay = 8;
  SdramTiming.SelfRefreshTime = 7;
  SdramTiming.RowCycleDelay = 7;
  SdramTiming.WriteRecoveryTime = 5;
  SdramTiming.RPDelay = 2;
  SdramTiming.RCDDelay = 2;

  if (HAL_SDRAM_Init(&hsdram1, &SdramTiming) != HAL_OK)
  {
    Error_Handler( );
  }

  /* USER CODE BEGIN FMC_Init 2 */
    sdram_initialization_sequence();
  /* USER CODE END FMC_Init 2 */
}

static uint32_t FMC_Initialized = 0;

static void HAL_FMC_MspInit(void){
  GPIO_InitTypeDef GPIO_InitStruct = {0};
  if (FMC_Initialized) {
    return;
  }
  FMC_Initialized = 1;
  RCC_PeriphCLKInitTypeDef PeriphClkInitStruct = {0};

  /** Initializes the peripherals clock
  */
    PeriphClkInitStruct.PeriphClockSelection = RCC_PERIPHCLK_FMC;
    PeriphClkInitStruct.FmcClockSelection = RCC_FMCCLKSOURCE_D1HCLK;
    if (HAL_RCCEx_PeriphCLKConfig(&PeriphClkInitStruct) != HAL_OK)
    {
      Error_Handler();
    }

  /* Peripheral clock enable */
  __HAL_RCC_FMC_CLK_ENABLE();

  /** FMC GPIO Configuration
  PE1   ------> FMC_NBL1
  PE0   ------> FMC_NBL0
  PG15   ------> FMC_SDNCAS
  PD0   ------> FMC_D2
  PD1   ------> FMC_D3
  PF0   ------> FMC_A0
  PF2   ------> FMC_A2
  PF1   ------> FMC_A1
  PG8   ------> FMC_SDCLK
  PF3   ------> FMC_A3
  PF4   ------> FMC_A4
  PH5   ------> FMC_SDNWE
  PF5   ------> FMC_A5
  PG5   ------> FMC_BA1
  PG4   ------> FMC_BA0
  PD15   ------> FMC_D1
  PG2   ------> FMC_A12
  PG1   ------> FMC_A11
  PH6   ------> FMC_SDNE1
  PD14   ------> FMC_D0
  PF13   ------> FMC_A7
  PG0   ------> FMC_A10
  PE13   ------> FMC_D10
  PH7   ------> FMC_SDCKE1
  PD10   ------> FMC_D15
  PF12   ------> FMC_A6
  PF15   ------> FMC_A9
  PE8   ------> FMC_D5
  PE9   ------> FMC_D6
  PE11   ------> FMC_D8
  PE14   ------> FMC_D11
  PD9   ------> FMC_D14
  PD8   ------> FMC_D13
  PF11   ------> FMC_SDNRAS
  PF14   ------> FMC_A8
  PE7   ------> FMC_D4
  PE10   ------> FMC_D7
  PE12   ------> FMC_D9
  PE15   ------> FMC_D12
  */
  /* GPIO_InitStruct */
  GPIO_InitStruct.Pin = GPIO_PIN_1|GPIO_PIN_0|GPIO_PIN_13|GPIO_PIN_8
                          |GPIO_PIN_9|GPIO_PIN_11|GPIO_PIN_14|GPIO_PIN_7
                          |GPIO_PIN_10|GPIO_PIN_12|GPIO_PIN_15;
  GPIO_InitStruct.Mode = GPIO_MODE_AF_PP;
  GPIO_InitStruct.Pull = GPIO_PULLUP;
  GPIO_InitStruct.Speed = GPIO_SPEED_FREQ_VERY_HIGH;
  GPIO_InitStruct.Alternate = GPIO_AF12_FMC;

  HAL_GPIO_Init(GPIOE, &GPIO_InitStruct);

  /* GPIO_InitStruct */
  GPIO_InitStruct.Pin = GPIO_PIN_15|GPIO_PIN_5|GPIO_PIN_4|GPIO_PIN_2
                          |GPIO_PIN_1|GPIO_PIN_0;
  GPIO_InitStruct.Mode = GPIO_MODE_AF_PP;
  GPIO_InitStruct.Pull = GPIO_PULLUP;
  GPIO_InitStruct.Speed = GPIO_SPEED_FREQ_VERY_HIGH;
  GPIO_InitStruct.Alternate = GPIO_AF12_FMC;

  HAL_GPIO_Init(GPIOG, &GPIO_InitStruct);

  /* GPIO_InitStruct */
  GPIO_InitStruct.Pin = GPIO_PIN_0|GPIO_PIN_1|GPIO_PIN_15|GPIO_PIN_14
                          |GPIO_PIN_10|GPIO_PIN_9|GPIO_PIN_8;
  GPIO_InitStruct.Mode = GPIO_MODE_AF_PP;
  GPIO_InitStruct.Pull = GPIO_PULLUP;
  GPIO_InitStruct.Speed = GPIO_SPEED_FREQ_VERY_HIGH;
  GPIO_InitStruct.Alternate = GPIO_AF12_FMC;

  HAL_GPIO_Init(GPIOD, &GPIO_InitStruct);

  /* GPIO_InitStruct */
  GPIO_InitStruct.Pin = GPIO_PIN_0|GPIO_PIN_2|GPIO_PIN_1|GPIO_PIN_3
                          |GPIO_PIN_4|GPIO_PIN_5|GPIO_PIN_13|GPIO_PIN_12
                          |GPIO_PIN_15|GPIO_PIN_11|GPIO_PIN_14;
  GPIO_InitStruct.Mode = GPIO_MODE_AF_PP;
  GPIO_InitStruct.Pull = GPIO_PULLUP;
  GPIO_InitStruct.Speed = GPIO_SPEED_FREQ_VERY_HIGH;
  GPIO_InitStruct.Alternate = GPIO_AF12_FMC;

  HAL_GPIO_Init(GPIOF, &GPIO_InitStruct);

  /* GPIO_InitStruct */
  GPIO_InitStruct.Pin = GPIO_PIN_8;
  GPIO_InitStruct.Mode = GPIO_MODE_AF_PP;
  GPIO_InitStruct.Pull = GPIO_NOPULL;
  GPIO_InitStruct.Speed = GPIO_SPEED_FREQ_VERY_HIGH;
  GPIO_InitStruct.Alternate = GPIO_AF12_FMC;

  HAL_GPIO_Init(GPIOG, &GPIO_InitStruct);

  /* GPIO_InitStruct */
  GPIO_InitStruct.Pin = GPIO_PIN_5|GPIO_PIN_6|GPIO_PIN_7;
  GPIO_InitStruct.Mode = GPIO_MODE_AF_PP;
  GPIO_InitStruct.Pull = GPIO_PULLUP;
  GPIO_InitStruct.Speed = GPIO_SPEED_FREQ_VERY_HIGH;
  GPIO_InitStruct.Alternate = GPIO_AF12_FMC;

  HAL_GPIO_Init(GPIOH, &GPIO_InitStruct);

}

void HAL_SDRAM_MspInit(SDRAM_HandleTypeDef* sdramHandle){
  HAL_FMC_MspInit();
}

static uint32_t FMC_DeInitialized = 0;

static void HAL_FMC_MspDeInit(void){
  if (FMC_DeInitialized) {
    return;
  }
  FMC_DeInitialized = 1;
  /* Peripheral clock enable */
  __HAL_RCC_FMC_CLK_DISABLE();

  /** FMC GPIO Configuration
  PE1   ------> FMC_NBL1
  PE0   ------> FMC_NBL0
  PG15   ------> FMC_SDNCAS
  PD0   ------> FMC_D2
  PD1   ------> FMC_D3
  PF0   ------> FMC_A0
  PF2   ------> FMC_A2
  PF1   ------> FMC_A1
  PG8   ------> FMC_SDCLK
  PF3   ------> FMC_A3
  PF4   ------> FMC_A4
  PH5   ------> FMC_SDNWE
  PF5   ------> FMC_A5
  PG5   ------> FMC_BA1
  PG4   ------> FMC_BA0
  PD15   ------> FMC_D1
  PG2   ------> FMC_A12
  PG1   ------> FMC_A11
  PH6   ------> FMC_SDNE1
  PD14   ------> FMC_D0
  PF13   ------> FMC_A7
  PG0   ------> FMC_A10
  PE13   ------> FMC_D10
  PH7   ------> FMC_SDCKE1
  PD10   ------> FMC_D15
  PF12   ------> FMC_A6
  PF15   ------> FMC_A9
  PE8   ------> FMC_D5
  PE9   ------> FMC_D6
  PE11   ------> FMC_D8
  PE14   ------> FMC_D11
  PD9   ------> FMC_D14
  PD8   ------> FMC_D13
  PF11   ------> FMC_SDNRAS
  PF14   ------> FMC_A8
  PE7   ------> FMC_D4
  PE10   ------> FMC_D7
  PE12   ------> FMC_D9
  PE15   ------> FMC_D12
  */

  HAL_GPIO_DeInit(GPIOE, GPIO_PIN_1|GPIO_PIN_0|GPIO_PIN_13|GPIO_PIN_8
                          |GPIO_PIN_9|GPIO_PIN_11|GPIO_PIN_14|GPIO_PIN_7
                          |GPIO_PIN_10|GPIO_PIN_12|GPIO_PIN_15);

  HAL_GPIO_DeInit(GPIOG, GPIO_PIN_15|GPIO_PIN_8|GPIO_PIN_5|GPIO_PIN_4
                          |GPIO_PIN_2|GPIO_PIN_1|GPIO_PIN_0);

  HAL_GPIO_DeInit(GPIOD, GPIO_PIN_0|GPIO_PIN_1|GPIO_PIN_15|GPIO_PIN_14
                          |GPIO_PIN_10|GPIO_PIN_9|GPIO_PIN_8);

  HAL_GPIO_DeInit(GPIOF, GPIO_PIN_0|GPIO_PIN_2|GPIO_PIN_1|GPIO_PIN_3
                          |GPIO_PIN_4|GPIO_PIN_5|GPIO_PIN_13|GPIO_PIN_12
                          |GPIO_PIN_15|GPIO_PIN_11|GPIO_PIN_14);

  HAL_GPIO_DeInit(GPIOH, GPIO_PIN_5|GPIO_PIN_6|GPIO_PIN_7);

}

void HAL_SDRAM_MspDeInit(SDRAM_HandleTypeDef* sdramHandle){
  HAL_FMC_MspDeInit();
}
/**
  * @}
  */

/**
  * @}
  */
