houhouoch/UDP3900/APP/UDP3900_4.2_read_back/Core/Src/usart.c

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
/* Includes ------------------------------------------------------------------*/
#include "usart.h"

/* USER CODE BEGIN 0 */

#define USART_REC_LEN   200                     
#define USART_EN_RX     0                       
#define RXBUFFERSIZE    1                       

#if (__ARMCC_VERSION >= 6010050)           
__asm(".global __use_no_semihosting\n\t"); 
__asm(".global __ARM_use_no_argv \n\t");  
#else
#pragma import(__use_no_semihosting)

struct __FILE
{
    int handle;
};

#endif
int _ttywrch(int ch)
{
    ch = ch;
    return ch;
}

void _sys_exit(int x)
{
    x = x;
}

char *_sys_command_string(char *cmd, int len)
{
    return NULL;
}
#include "stdio.h"
FILE __stdout;
int fputc(int ch, FILE *f)
{
    while ((UART7->ISR & 0X40) == 0);    

    UART7->TDR = (uint8_t)ch;            
    return ch;
}

uint8_t g_usart_rx_buf[USART_REC_LEN];

uint16_t g_usart_rx_sta = 0;

uint8_t g_rx_buffer[RXBUFFERSIZE]; 
/* USER CODE END 0 */

UART_HandleTypeDef huart7;
DMA_HandleTypeDef hdma_uart7_rx;

/* UART7 init function */
void MX_UART7_Init(void)
{

  huart7.Instance = UART7;
  huart7.Init.BaudRate = 460800;
  huart7.Init.WordLength = UART_WORDLENGTH_8B;
  huart7.Init.StopBits = UART_STOPBITS_1;
  huart7.Init.Parity = UART_PARITY_NONE;
  huart7.Init.Mode = UART_MODE_TX_RX;
  huart7.Init.HwFlowCtl = UART_HWCONTROL_NONE;
  huart7.Init.OverSampling = UART_OVERSAMPLING_16;
  huart7.Init.OneBitSampling = UART_ONE_BIT_SAMPLE_DISABLE;
  huart7.Init.ClockPrescaler = UART_PRESCALER_DIV1;
  huart7.AdvancedInit.AdvFeatureInit = UART_ADVFEATURE_NO_INIT;
  if (HAL_UART_Init(&huart7) != HAL_OK)
  {
    Error_Handler();
  }
  if (HAL_UARTEx_SetTxFifoThreshold(&huart7, UART_TXFIFO_THRESHOLD_1_8) != HAL_OK)
  {
    Error_Handler();
  }
  if (HAL_UARTEx_SetRxFifoThreshold(&huart7, UART_RXFIFO_THRESHOLD_1_8) != HAL_OK)
  {
    Error_Handler();
  }
  if (HAL_UARTEx_DisableFifoMode(&huart7) != HAL_OK)
  {
    Error_Handler();
  }
}

void HAL_UART_MspInit(UART_HandleTypeDef* uartHandle)
{

  GPIO_InitTypeDef GPIO_InitStruct = {0};
  RCC_PeriphCLKInitTypeDef PeriphClkInitStruct = {0};
  if(uartHandle->Instance==UART7)
  {
  /** Initializes the peripherals clock
  */
    PeriphClkInitStruct.PeriphClockSelection = RCC_PERIPHCLK_UART7;
    PeriphClkInitStruct.Usart234578ClockSelection = RCC_USART234578CLKSOURCE_D2PCLK1;
    if (HAL_RCCEx_PeriphCLKConfig(&PeriphClkInitStruct) != HAL_OK)
    {
      Error_Handler();
    }

    /* UART7 clock enable */
    __HAL_RCC_UART7_CLK_ENABLE();

    __HAL_RCC_GPIOA_CLK_ENABLE();
    __HAL_RCC_GPIOF_CLK_ENABLE();
    /**UART7 GPIO Configuration
    PA15 (JTDI)     ------> UART7_TX
    PF6     ------> UART7_RX
    */
    GPIO_InitStruct.Pin = UART7_T_Pin;
    GPIO_InitStruct.Mode = GPIO_MODE_AF_PP;
    GPIO_InitStruct.Pull = GPIO_PULLUP;
    GPIO_InitStruct.Speed = GPIO_SPEED_FREQ_LOW;
    GPIO_InitStruct.Alternate = GPIO_AF11_UART7;
    HAL_GPIO_Init(UART7_T_GPIO_Port, &GPIO_InitStruct);

    GPIO_InitStruct.Pin = UART7_R_Pin;
    GPIO_InitStruct.Mode = GPIO_MODE_AF_PP;
    GPIO_InitStruct.Pull = GPIO_NOPULL;
    GPIO_InitStruct.Speed = GPIO_SPEED_FREQ_LOW;
    GPIO_InitStruct.Alternate = GPIO_AF7_UART7;
    HAL_GPIO_Init(UART7_R_GPIO_Port, &GPIO_InitStruct);

    /* UART7 DMA Init */
    /* UART7_RX Init */
    hdma_uart7_rx.Instance = DMA1_Stream0;
    hdma_uart7_rx.Init.Request = DMA_REQUEST_UART7_RX;
    hdma_uart7_rx.Init.Direction = DMA_PERIPH_TO_MEMORY;
    hdma_uart7_rx.Init.PeriphInc = DMA_PINC_DISABLE;
    hdma_uart7_rx.Init.MemInc = DMA_MINC_ENABLE;
    hdma_uart7_rx.Init.PeriphDataAlignment = DMA_PDATAALIGN_BYTE;
    hdma_uart7_rx.Init.MemDataAlignment = DMA_MDATAALIGN_BYTE;
    hdma_uart7_rx.Init.Mode = DMA_NORMAL;
    hdma_uart7_rx.Init.Priority = DMA_PRIORITY_LOW;
    hdma_uart7_rx.Init.FIFOMode = DMA_FIFOMODE_DISABLE;
    if (HAL_DMA_Init(&hdma_uart7_rx) != HAL_OK)
    {
      Error_Handler();
    }

    __HAL_LINKDMA(uartHandle,hdmarx,hdma_uart7_rx);

    /* UART7 interrupt Init */
    HAL_NVIC_SetPriority(UART7_IRQn, 5, 0);
    HAL_NVIC_EnableIRQ(UART7_IRQn);
  }
}

void HAL_UART_MspDeInit(UART_HandleTypeDef* uartHandle)
{

  if(uartHandle->Instance==UART7)
  {
    /* Peripheral clock disable */
    __HAL_RCC_UART7_CLK_DISABLE();

    /**UART7 GPIO Configuration
    PA15 (JTDI)     ------> UART7_TX
    PF6     ------> UART7_RX
    */
    HAL_GPIO_DeInit(UART7_T_GPIO_Port, UART7_T_Pin);

    HAL_GPIO_DeInit(UART7_R_GPIO_Port, UART7_R_Pin);

    /* UART7 DMA DeInit */
    HAL_DMA_DeInit(uartHandle->hdmarx);

    /* UART7 interrupt Deinit */
    HAL_NVIC_DisableIRQ(UART7_IRQn);
  }
}

/* USER CODE BEGIN 1 */
void HAL_UART_RxCpltCallback(UART_HandleTypeDef *huart)
{
    if(huart->Instance == UART7)                             
    {
        if((g_usart_rx_sta & 0x8000) == 0)                    
        {                        
        }       
    }
    HAL_UART_Receive_IT(&huart7, (uint8_t *)g_rx_buffer, RXBUFFERSIZE);
}
/* USER CODE END 1 */
