houhouoch/UDP3900/APP/UDP3900_4.2_read_back/Core/Src/dma2d.c

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
/* Includes ------------------------------------------------------------------*/
#include "dma2d.h"

DMA2D_HandleTypeDef hdma2d;

/* DMA2D init function */
void MX_DMA2D_Init(void)
{

  hdma2d.Instance = DMA2D;
  hdma2d.Init.Mode = DMA2D_M2M;
  hdma2d.Init.ColorMode = DMA2D_OUTPUT_RGB565;
  hdma2d.Init.OutputOffset = 0;
  hdma2d.LayerCfg[1].InputOffset = 0;
  hdma2d.LayerCfg[1].InputColorMode = DMA2D_INPUT_RGB565;
  hdma2d.LayerCfg[1].AlphaMode = DMA2D_NO_MODIF_ALPHA;
  hdma2d.LayerCfg[1].InputAlpha = 0;
  hdma2d.LayerCfg[1].AlphaInverted = DMA2D_REGULAR_ALPHA;
  hdma2d.LayerCfg[1].RedBlueSwap = DMA2D_RB_REGULAR;
  hdma2d.LayerCfg[1].ChromaSubSampling = DMA2D_NO_CSS;
  if (HAL_DMA2D_Init(&hdma2d) != HAL_OK)
  {
    Error_Handler();
  }
  if (HAL_DMA2D_ConfigLayer(&hdma2d, 1) != HAL_OK)
  {
    Error_Handler();
  }
}

void HAL_DMA2D_MspInit(DMA2D_HandleTypeDef* dma2dHandle)
{

  if(dma2dHandle->Instance==DMA2D)
  {
    /* DMA2D clock enable */
    __HAL_RCC_DMA2D_CLK_ENABLE();

    /* DMA2D interrupt Init */
    HAL_NVIC_SetPriority(DMA2D_IRQn, 5, 0);
    HAL_NVIC_EnableIRQ(DMA2D_IRQn);
  }
}

void HAL_DMA2D_MspDeInit(DMA2D_HandleTypeDef* dma2dHandle)
{

  if(dma2dHandle->Instance==DMA2D)
  {
    /* Peripheral clock disable */
    __HAL_RCC_DMA2D_CLK_DISABLE();

    /* DMA2D interrupt Deinit */
    HAL_NVIC_DisableIRQ(DMA2D_IRQn);
  }
}

/* USER CODE BEGIN 1 */

osThreadId_t drawingTaskHandle = NULL; // 记录当前是谁在用 DMA2D

/* 1. 定义互斥量句柄 */
osMutexId_t dma2dMutexHandle;
/* 3. 在初始化函数中创建互斥量  */
void DMA2D_Mutex_Init(void) {
    const osMutexAttr_t Thread_Mutex_attr = {
        "dma2dMutex",                          // 名字
        osMutexRecursive| osMutexPrioInherit, 
        NULL, 0
    };
    dma2dMutexHandle = osMutexNew(&Thread_Mutex_attr);
}

/**
 * @brief  DMA2D 纯色填充函数 (R2M 模式)
 * @param  sx, sy: 起始坐标
 * @param  ex, ey: 结束坐标
 * @param  color:  填充的颜色 (RGB565格式)
 */
void ltdc_fill(uint16_t sx, uint16_t sy, uint16_t ex, uint16_t ey, uint32_t color)
{
    // 1. 抢占互斥锁 (Mutex)
    if (osMutexAcquire(dma2dMutexHandle, osWaitForever) != osOK) return;

    uint32_t width  = ex - sx + 1;
    uint32_t height = ey - sy + 1;
    uint16_t offline = 240 - width; // 屏幕宽度减去填充宽度
    uint32_t addr = 0xD0000000 + 2 * (240 * sy + sx); // 目标显存地址
    /* 记录当前正在调用的任务 ID */
    drawingTaskHandle = osThreadGetId();    
    
    DMA2D->CR = DMA2D_R2M; 
    DMA2D->OCOLR = color; 
    DMA2D->OMAR = addr;
    DMA2D->OOR  = offline;
    DMA2D->OPFCCR = LTDC_PIXEL_FORMAT_RGB565;
    DMA2D->NLR = (height) | (width << 16);

    DMA2D->IFCR |= DMA2D_IFCR_CTCIF; 
    DMA2D->CR   |= DMA2D_CR_TCIE;
    /*  启动填充 */
    DMA2D->CR |= DMA2D_CR_START;
    /* 阻塞当前调用的任务 */
    osThreadFlagsWait(SIGNAL_DMA2D_TC, osFlagsWaitAll, osWaitForever);
    
    //  释放互斥锁
    osMutexRelease(dma2dMutexHandle);
}




/**
 * @brief  使用 DMA2D 将颜色缓冲区数据搬运至显存指定区域
 * @param  sx, sy: 起始坐标
 * @param  ex, ey: 结束坐标
 * @param  color: 指向源颜色缓冲区（如 LVGL 的 color_p）的指针
 */
void ltdc_color_fill(uint16_t sx, uint16_t sy, uint16_t ex, uint16_t ey, uint16_t *color)
{    
    //  抢占互斥锁 (Mutex)
    if (osMutexAcquire(dma2dMutexHandle, osWaitForever) != osOK) return;
    uint32_t width  = ex - sx + 1;
    uint32_t height = ey - sy + 1;
    uint32_t addr   = 0xD0000000 + 2 * (240 * sy + sx); 
    /* 记录当前正在调用的任务 ID */
    drawingTaskHandle = osThreadGetId();
    /*  Cache 管理：确保 DMA2D 读到的是最新的内存数据 */
    SCB_CleanDCache_by_Addr((uint32_t*)color, width * height * 2);
    /*  配置模式与地址 */
    DMA2D->CR      = DMA2D_M2M;                      // 存储器到存储器模式
    DMA2D->FGMAR   = (uint32_t)color;                 // 源：LVGL 缓冲区
    DMA2D->OMAR    = addr;                            // 目：SDRAM 显存
    DMA2D->FGOR    = 0;                               // 源偏移
    DMA2D->OOR     = 240 - width;                     // 目标偏移 (屏幕宽度 - 填充宽度)
    DMA2D->FGPFCCR = LTDC_PIXEL_FORMAT_RGB565;        // 输入格式
    DMA2D->OPFCCR  = LTDC_PIXEL_FORMAT_RGB565;        // 输出格式
    DMA2D->NLR     = (height) | (width << 16);        // 设置宽高    
    /*  开启中断并启动 */
    DMA2D->IFCR |= DMA2D_IFCR_CTCIF;                  // 先清一次标志位
    DMA2D->CR   |= DMA2D_CR_TCIE;                     // 使能传输完成中断
    DMA2D->CR   |= DMA2D_CR_START;                    // 开启搬运
    /* 阻塞当前调用的任务 */
    osThreadFlagsWait(SIGNAL_DMA2D_TC, osFlagsWaitAll, osWaitForever);  
    //  释放互斥锁
    osMutexRelease(dma2dMutexHandle);
}


/* USER CODE END 1 */
