houhouoch/UDP3900/(commit log)

2026-03-25 [提交]
    [1U 按键.PrjPcb, 1U 按键.SchDoc, 1U 显示.PcbDoc, 1U 显示.PrjPcb, 1U 显示.SchDoc, 通用核心板.PrjPcb, 通用核心板.SchDoc]
2026-03-25 [增加]LTDC
2026-03-26 [添加]
2026-03-26 [添加]DMA2D
2026-03-26 [添加]RTOS
2026-03-26 [添加]LVGL
2026-03-27 [添加]DMA2D+MUTEX+LVGL_TEST
2026-03-27 [添加]BTN 完成
2026-03-27 Revise README for DMA2D project documentation
    Updated the README to include detailed explanations of DMA2D hardware acceleration, driver architecture, synchronization mechanisms, screen validation tests, and adaptation points for the left-cut screen.
2026-03-27 Revise README for ST7701S and STM32H750 integration
    Updated the README to clarify hardware limitations and software solutions for ST7701S and STM32H750 integration.
2026-04-01 [添加]CAN通信
2026-04-02 [添加]驱动后面板启停、以及电压的设置
2026-04-02 [添加]回读
