houhouoch/UDP3900/(notices)

Notices in the files:
APP/UDP3900_4.2_read_back/Core/Src/usart.c:
Copyright (c) 2026 STMicroelectronics.
All rights reserved.
This software is licensed under terms that can be found in the LICENSE file
